drewsum/HEI_Shift_Light/hdw/misc/pcb_scan.jpg

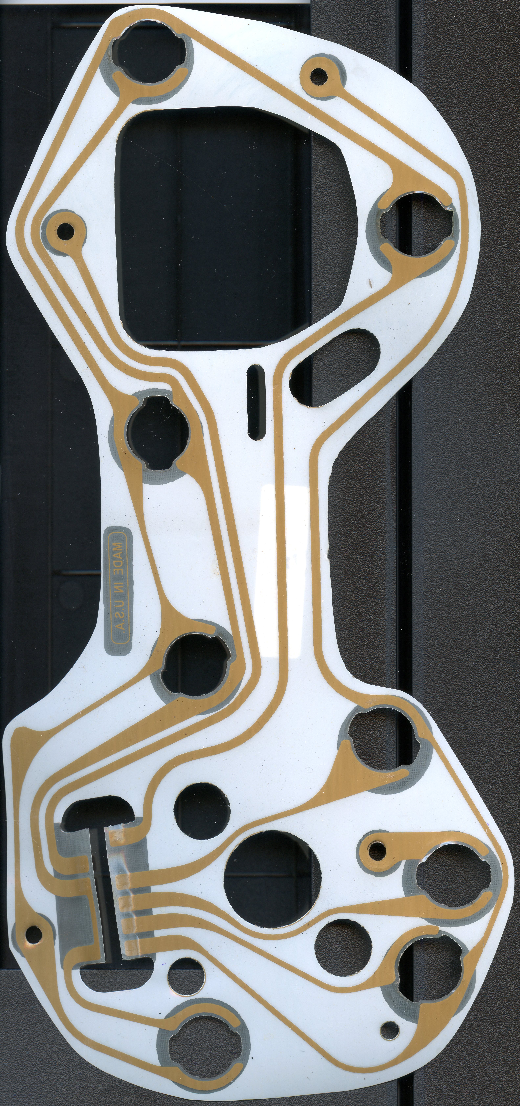
hdw/misc/pcb_scan.jpg
