drewsum/HEI_Shift_Light/README.md

# HEI_Shift_Light
An automotive shift light meant to integrate into the TACH signal from an HEI distributor, to be embedded in a dashboard
