drewsum/HEI_Shift_Light/hdw/misc/indicator_insert.jpg

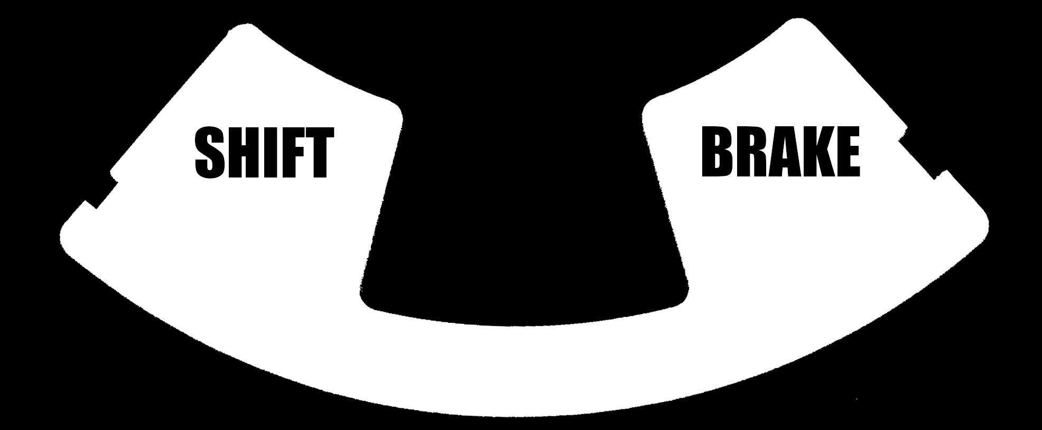
hdw/misc/indicator_insert.jpg
