drewsum/HEI_Shift_Light/hdw/misc/indicator_insert_original.jpg

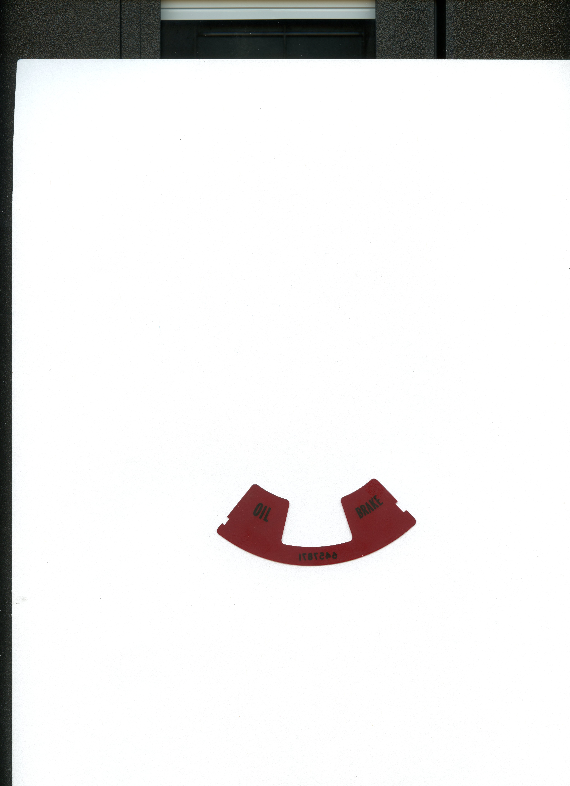
hdw/misc/indicator_insert_original.jpg
