drewsum/HEI_Shift_Light/hdw/misc/ref_photos/PXL_20260610_023209408.jpg

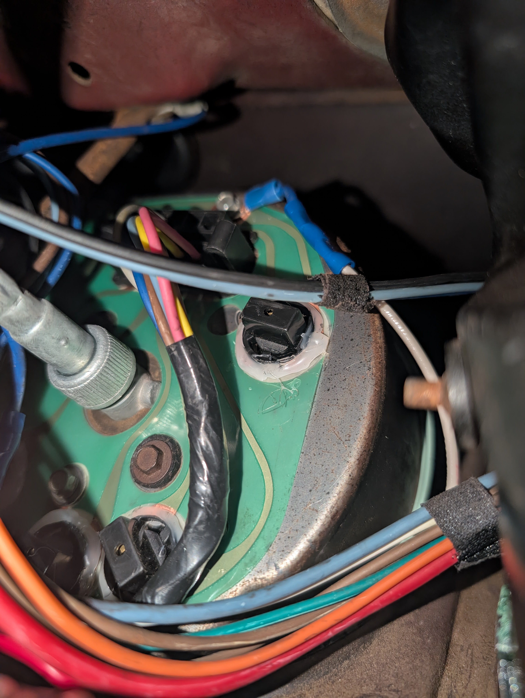
hdw/misc/ref_photos/PXL_20260610_023209408.jpg
