drewsum/HEI_Shift_Light/hdw/HEI_Shift_Light/HEI_Shift_Light.pdf

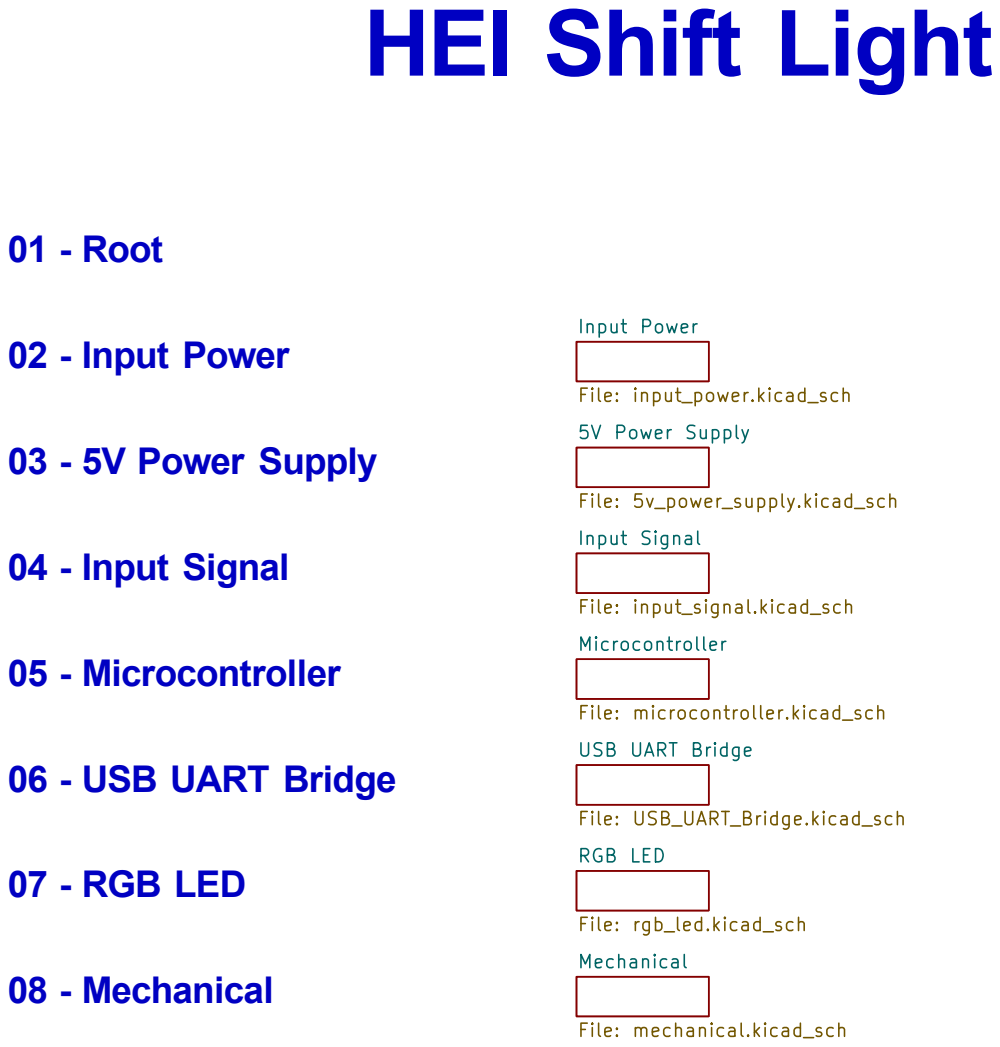
[picture p8: page 1]

Input Power File: input_power.kicad_sch 5V Power Supply File: 5v_power_supply.kicad_sch Mechanical File: mechanical.kicad_sch

Input Signal File: input_signal.kicad_sch Microcontroller File: microcontroller.kicad_sch USB UART Bridge

Drew Maatman
Sheet: /
File: HEI_Shift_Light.kicad_sch
Title: HEI Shift Light

Size: A | Rev: A
KiCad E.D.A. 10.0.3 | Id: 1/8

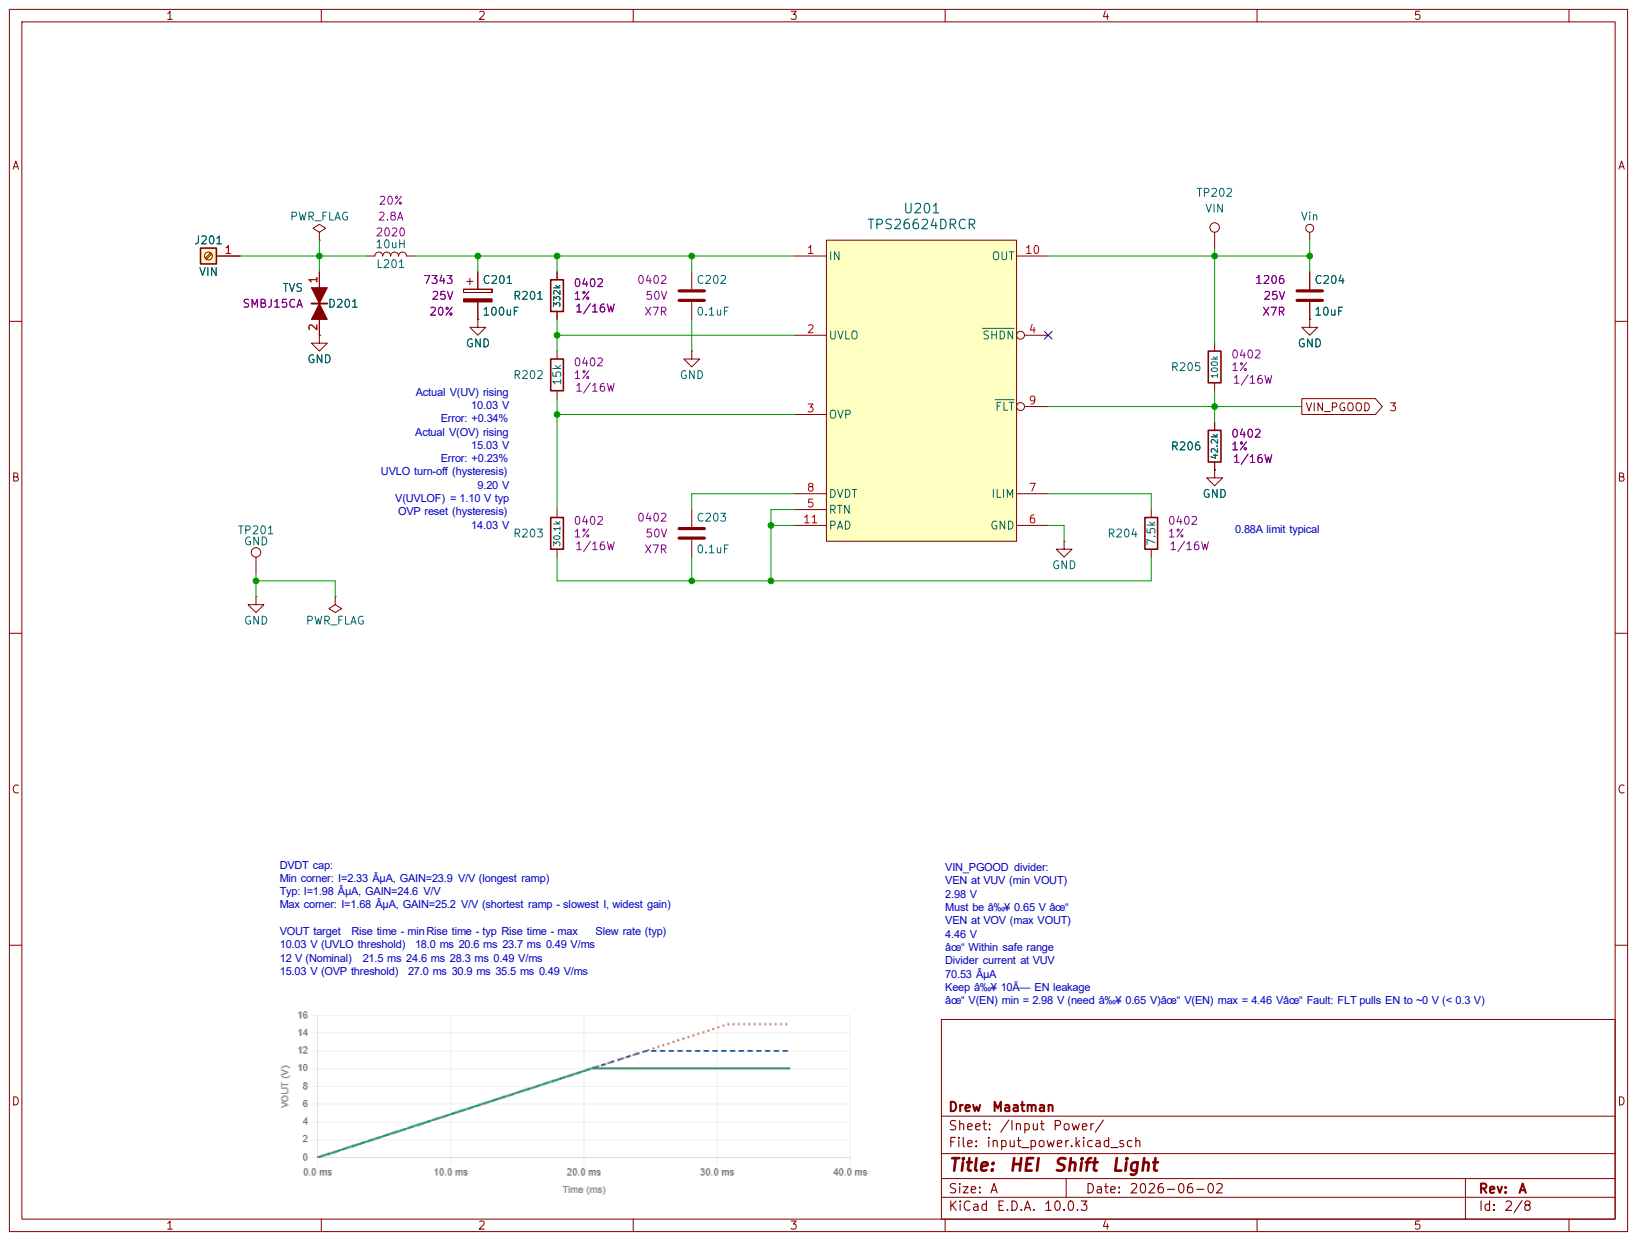
[picture p9: page 2]

0.88A limit typical Actual V(UV) rising

UVLO turn-off (hysteresis) 9.20 V

âœ“ V(EN) min = 2.98 V (need â‰¥ 0.65 V)âœ“ V(EN) max = 4.46 Vâœ“ Fault: FLT pulls EN to ~0 V (< 0.3 V) DVDT cap: Min corner: I=2.33 ÂµA, GAIN=23.9 V/V (longest ramp)

VIN_PGOOD divider: VEN at VUV (min VOUT) 2.98 V Must be â‰¥ 0.65 V âœ“ VEN at VOV (max VOUT) 4.46 V

âœ“ Within safe range Divider current at VUV

Drew Maatman
Sheet: /Input Power/
File: input_power.kicad_sch
Title: HEI Shift Light

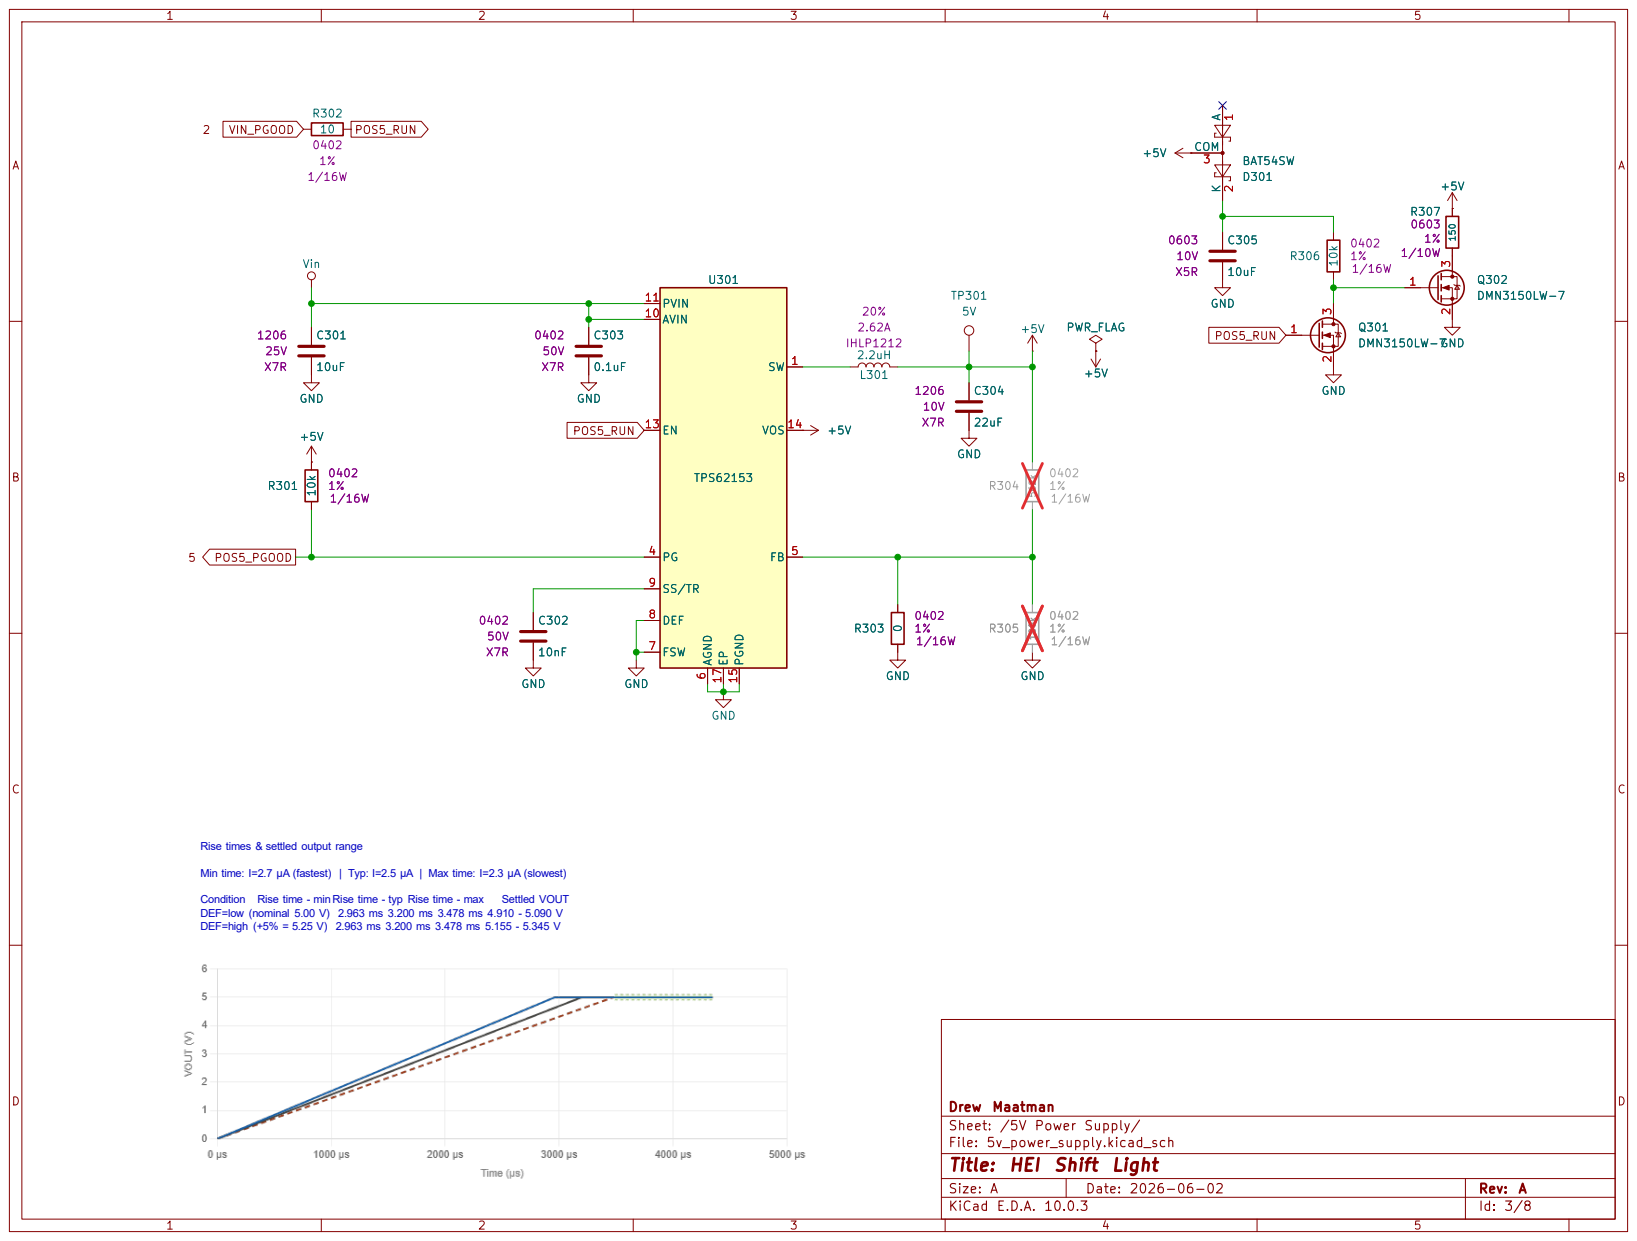
[picture p10: page 3]

Drew Maatman
Sheet: /5V Power Supply/
File: 5v_power_supply.kicad_sch
Title: HEI Shift Light

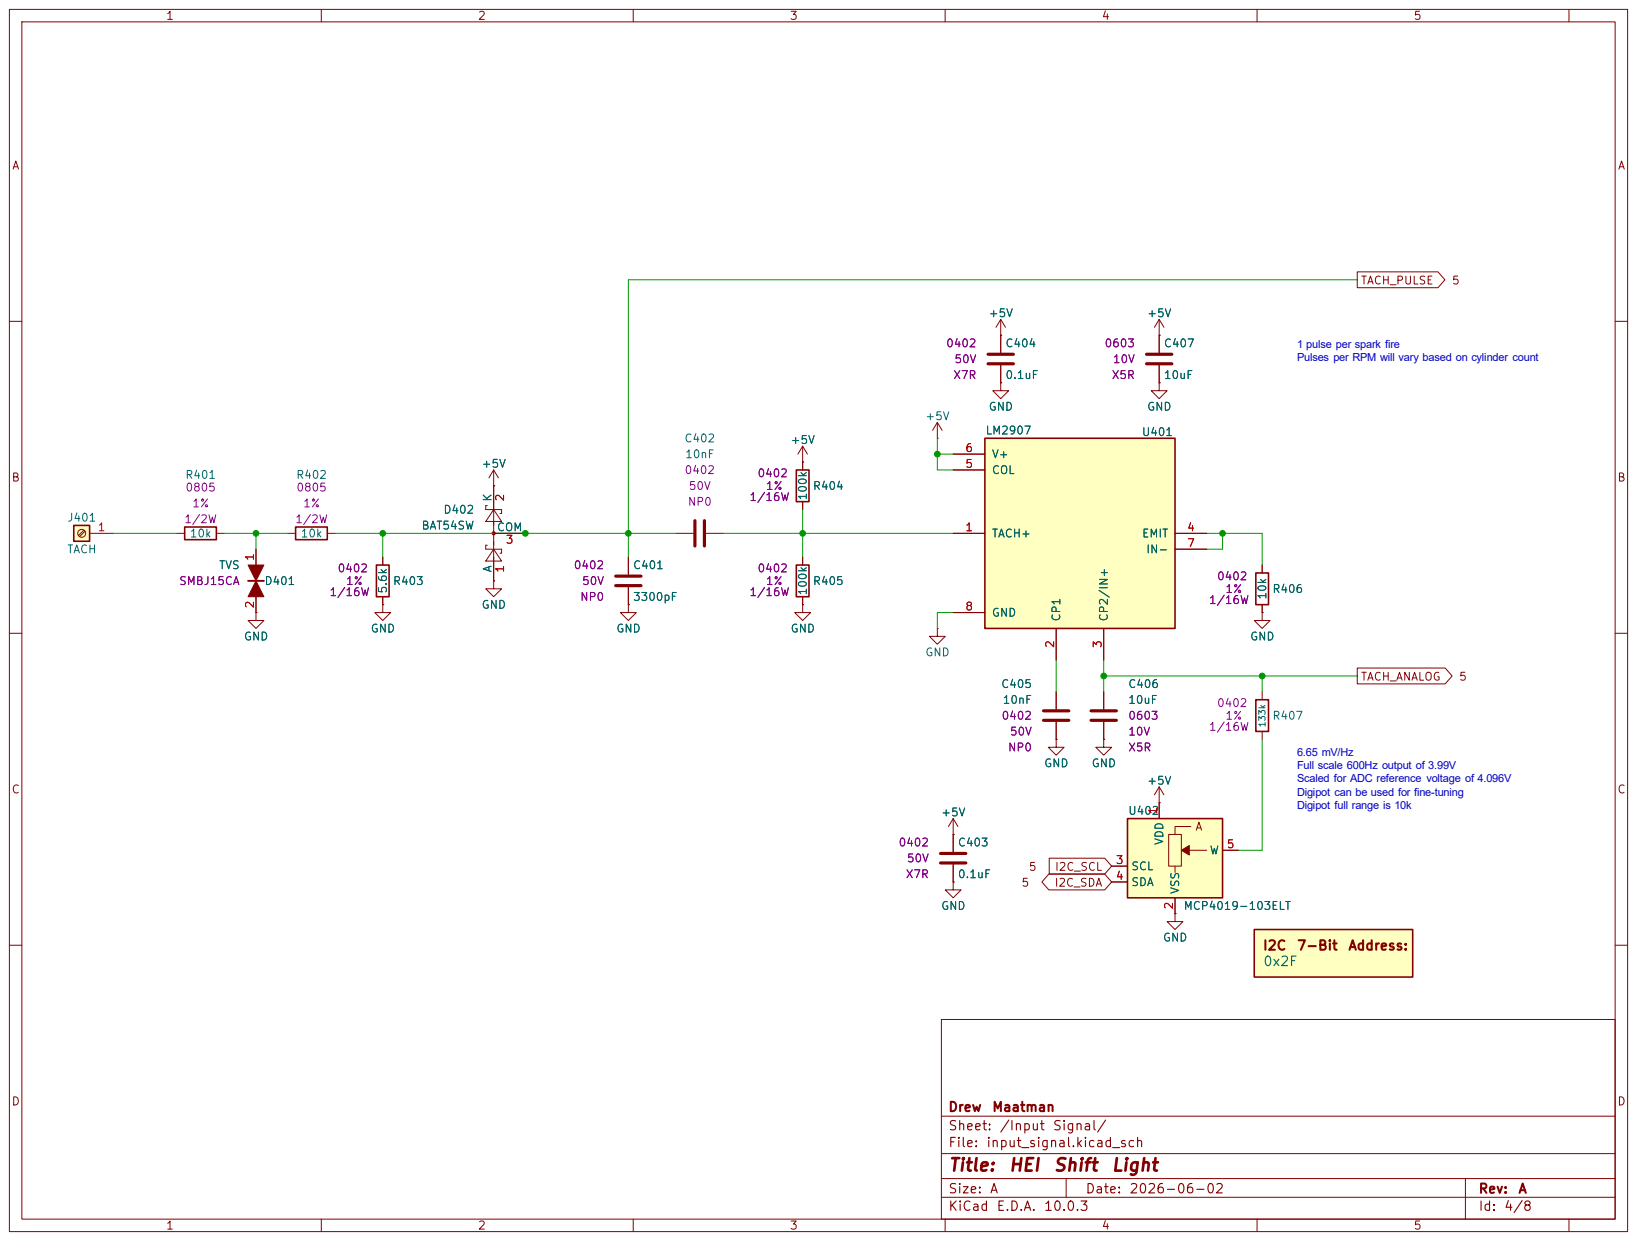
[picture p11: page 4]

1 pulse per spark fire Pulses per RPM will vary based on cylinder count C401

6.65 mV/Hz Full scale 600Hz output of 3.99V

Scaled for ADC reference voltage of 4.096V Digipot can be used for fine-tuning

Digipot full range is 10k

Drew Maatman
Sheet: /Input Signal/
File: input_signal.kicad_sch
Title: HEI Shift Light

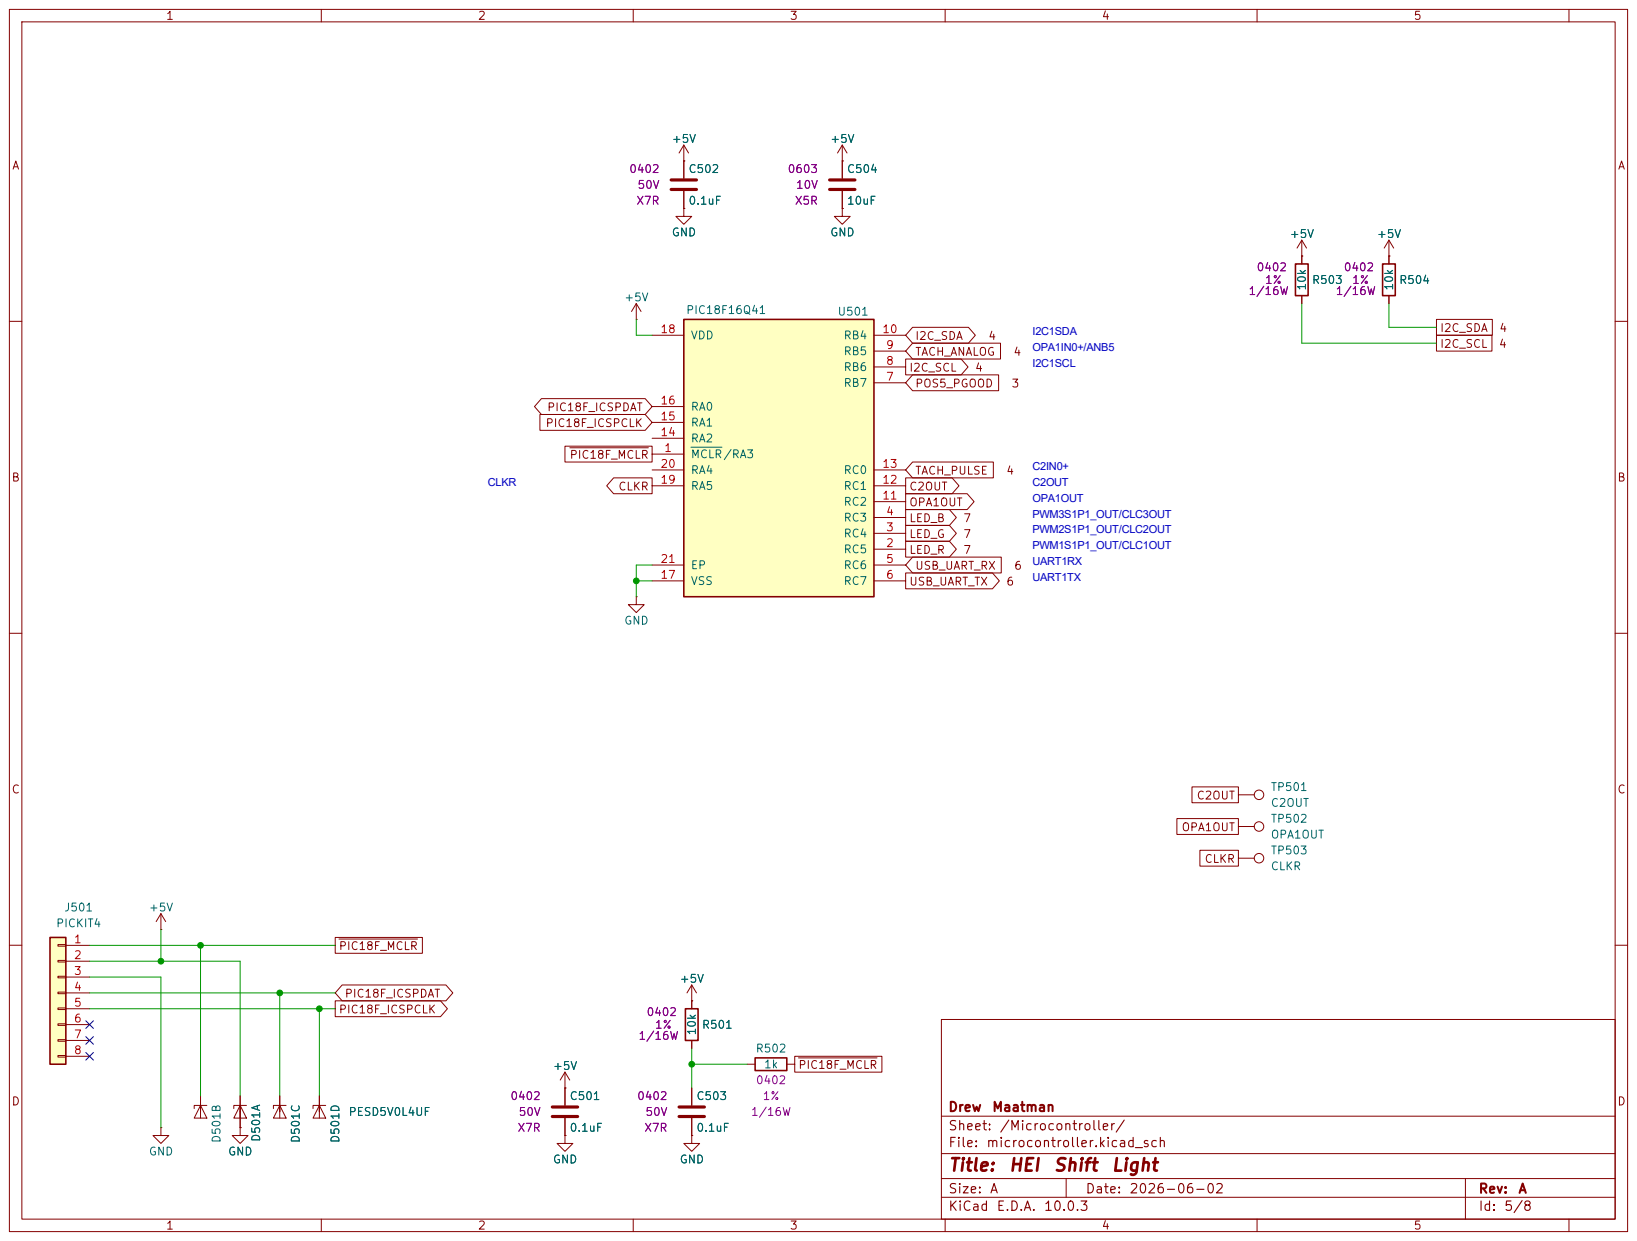
[picture p12: page 5]

Drew Maatman
Sheet: /Microcontroller/
File: microcontroller.kicad_sch
Title: HEI Shift Light

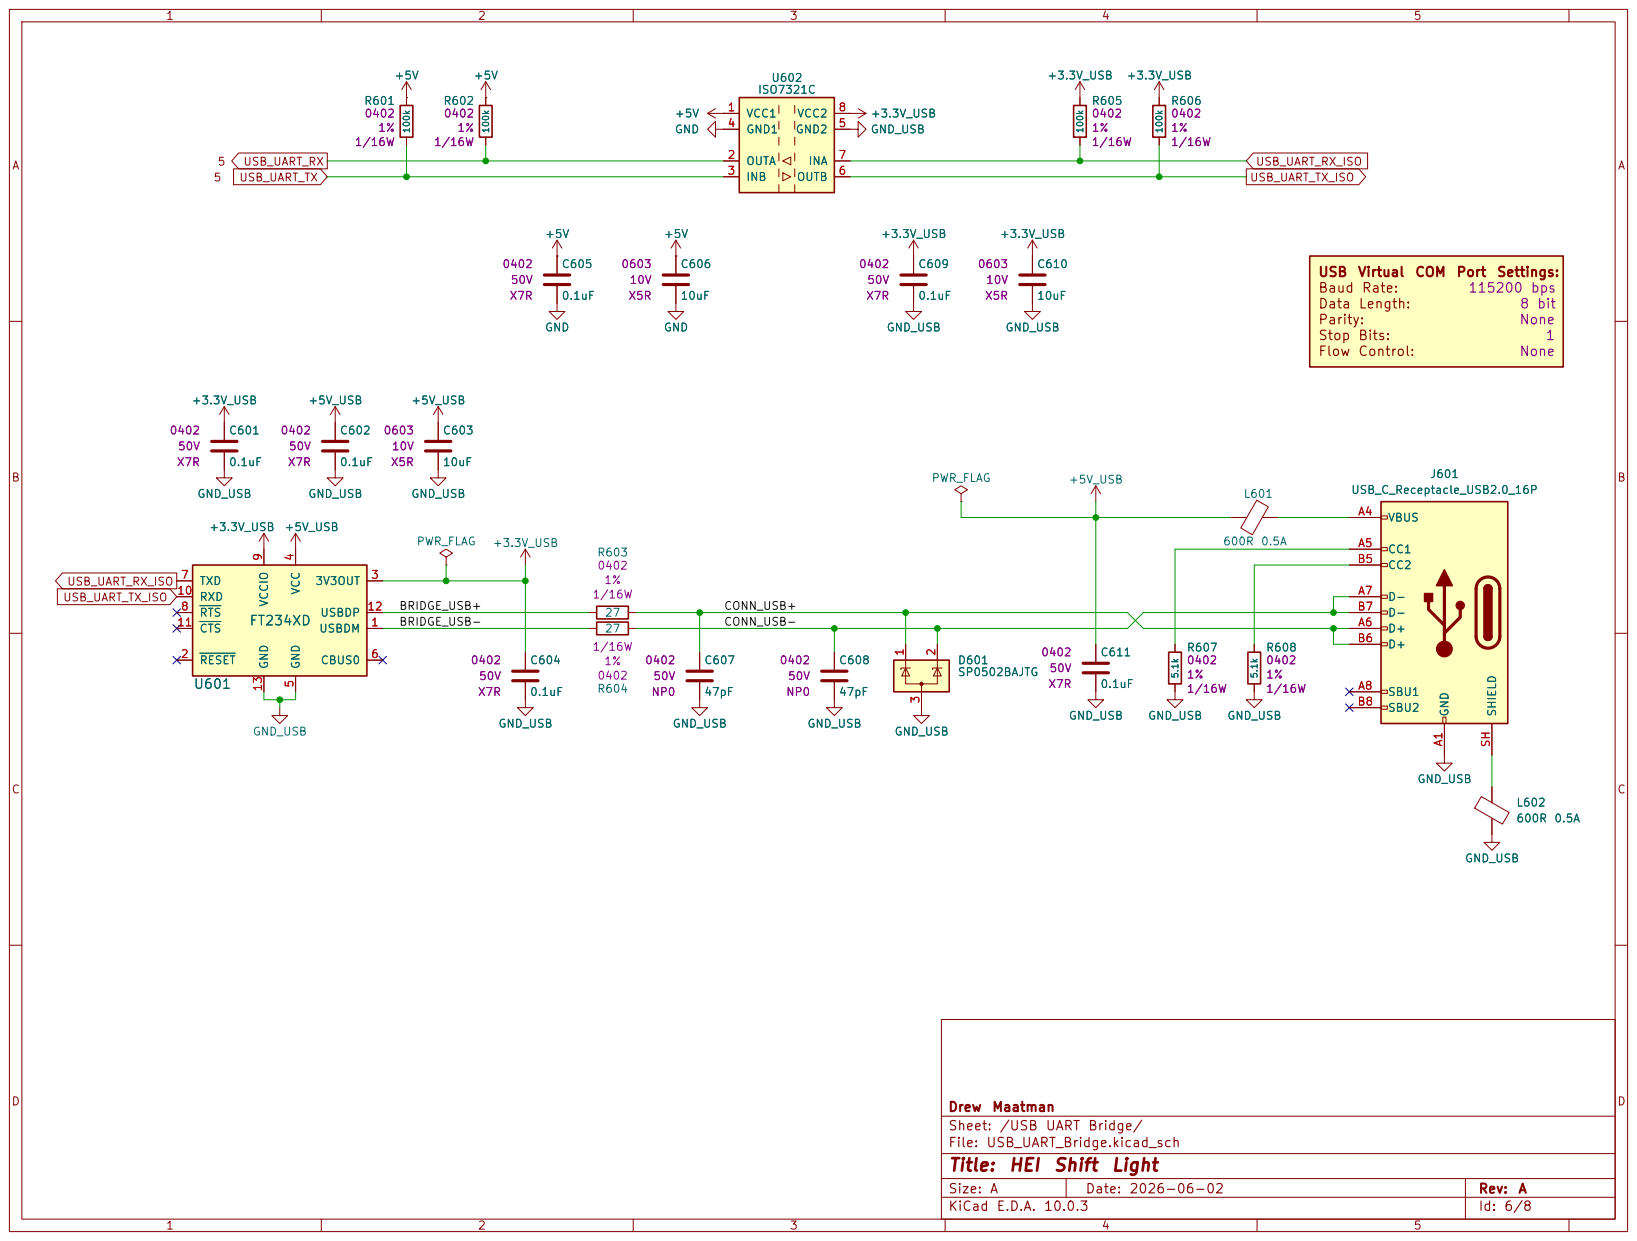
[picture p13: page 6]

USB Virtual COM Port Settings:
Baud Rate:
Data Length:
Parity:
Stop Bits:
Flow Control:

9 RXD 10 CTS 11 USBDP 12 GND

9 RXD 10 CTS 11 USBDP 12 GND 13 C604

Drew Maatman
Sheet: /USB UART Bridge/
File: USB_UART_Bridge.kicad_sch
Title: HEI Shift Light

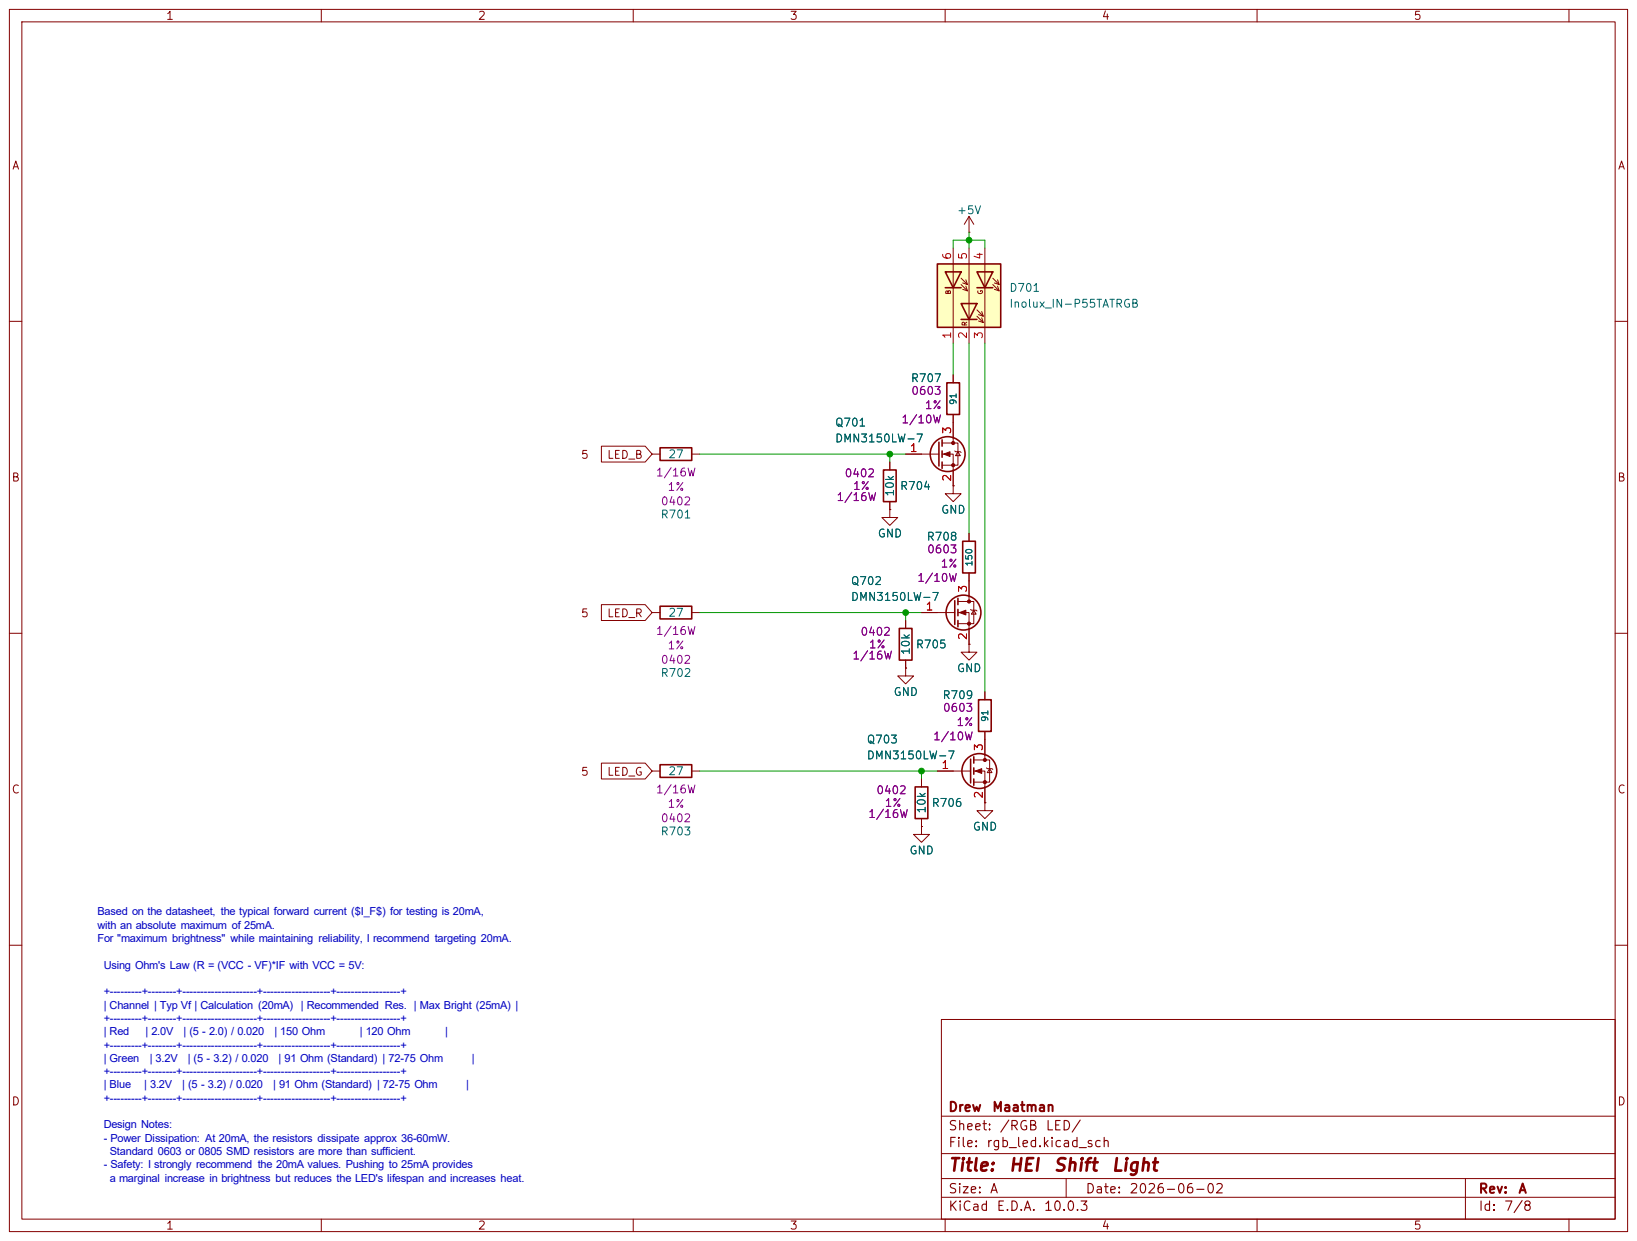
[picture p14: page 7]

Based on the datasheet, the typical forward current ($I_F$) for testing is 20mA, with an absolute maximum of 25mA. For "maximum brightness" while maintaining reliability, I recommend targeting 20mA. Using Ohm's Law (R = (VCC - VF)*IF with VCC = 5V: +---------+--------+---------------------+-------------------+------------------+

Channel | Typ Vf | Calculation (20mA) | Recommended Res. | Max Bright (25mA) | +---------+--------+---------------------+-------------------+------------------+

Drew Maatman
Sheet: /RGB LED/
File: rgb_led.kicad_sch
Title: HEI Shift Light

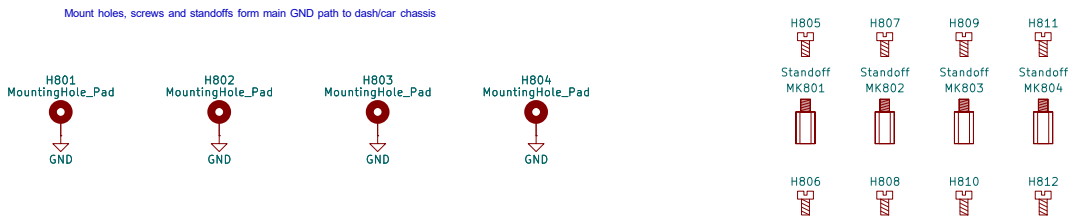
[picture p15: page 8]

Drew Maatman
Sheet: /Mechanical/
File: mechanical.kicad_sch
Title: HEI Shift Light
