drewsum/HEI_Shift_Light/hdw/sim/input_signal/input_signal_draft.asc

C1: cap; 10n
C2: cap; 10n
C3: cap; 1µ
C401: cap; 3300p
D1: schottky; BAT54AHY
D2: schottky; BAT54AHY
D3: TVSdiode; SMBJ24CA
R1: res; 100k
R2: res; 100k
R3: res; 10k
R4: res; 133k
R401: res; 10k
R402: res; 10k
R403: res; 5.6k
U1: LM2907-8
V1: voltage; 5
VTACH: voltage; PWL file=HEI_TACH_V8_1000to6000RPM_10s.txt
Named nets: 0, tach_raw, tach_clamped, vcc, LM2907_IN, tach_tvs, LM2907_OUT
HEI TACH signal at J401
V8 @ 1000 RPM (66.67 Hz, T=15ms)
High: 13.8V (battery / open-collector)
Low:  0.5V  (HEI NPN Vce_sat / dwell)
Flyback: -40V neg spike, +65V ring, damped settle
Alt ripple baked into high state (+/-0.3V shape)
.tran 0 10 0 500n
