drewsum/HEI_Shift_Light/hdw/HEI_Shift_Light/HEI_Shift_Light.kicad_pcb

## KiCad design hdw/HEI_Shift_Light/HEI_Shift_Light.kicad_pcb (2026-07-17)

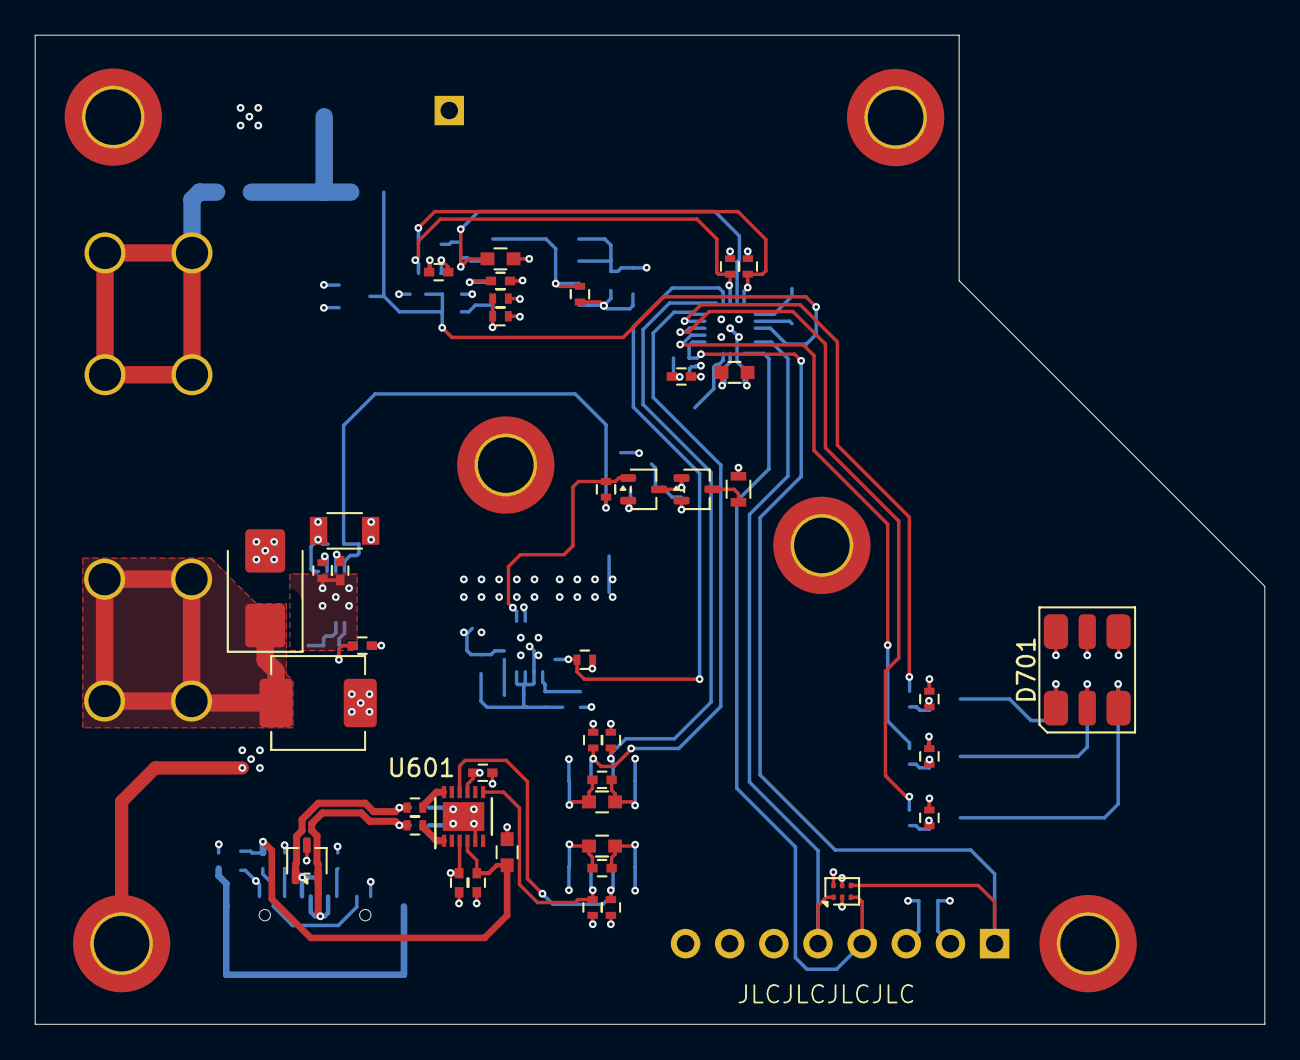
[picture p16: board HEI_Shift_Light.kicad_pcb from above]

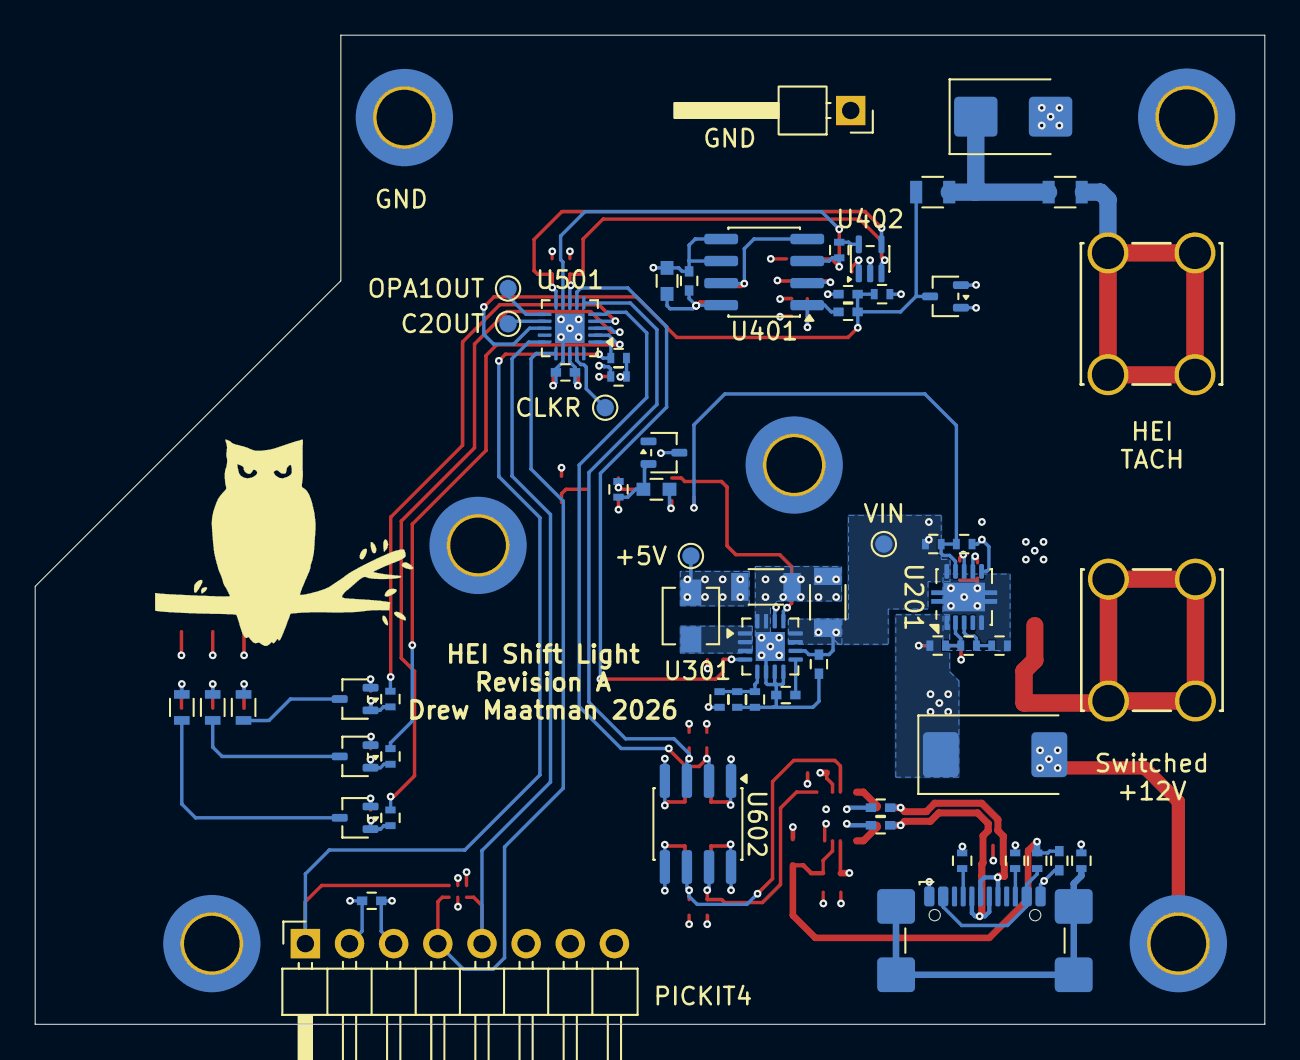
[picture p17: board HEI_Shift_Light.kicad_pcb from below]

Board: 4 copper layers, 70.7 x 56.9 mm, 111 parts (63 on the bottom side), 63 nets.

Parts:
C201: 100uF; CP_EIA-7343-43_Kemet-X
C202, C203, C303, C403, C404, C501, C502, C503, C601, C602, C604, C605, C609, C611: 0.1uF; C_0402
C204, C301: 10uF; C_1206
C302, C402, C405: 10nF; C_0402
C304: 22uF; C_1206
C305, C406, C407, C504, C603, C606, C610: 10uF; C_0603
C401: 3300pF; C_0402
C607, C608: 47pF; C_0402
D201, D401: TVS; D_SMB
D301, D402: BAT54SW; SOT-323_SC-70
D501: PESD5V0L4UF; SOT-886
D601: SP0502BAJTG; SOT-323_SC-70
D701: Inolux_IN-P55TATRGB; LED_Inolux_IN-P55TATRGB_PLCC6_5.0x5.5mm_P1.8mm
H801, H802, H803, H804, H813, H814: MountingHole_Pad; MountingHole_3.2mm_M3_DIN965_Pad_TopBottom
J201: VIN; CONN_7691_KEY
J401: TACH; CONN_7691_KEY
J501: PICKIT4; PICKIT4_Header
J601: USB_C_Receptacle_USB2.0_16P; USB_C_Receptacle_GCT_USB4110
L201: 10uH; L_Vishay_IHLP-2020
L301: 2.2uH; L_Vishay_IHLP-1212
L601, L602: 600R 0.5A; L_0402
Q301, Q302, Q701, Q702, Q703: DMN3150LW-7; SOT-323_SC-70
R201: 332k; R_0402
R202: 15k; R_0402
R203: 30.1k; R_0402
R204: 7.5k; R_0402
R205, R404, R405, R601, R602, R605, R606: 100k; R_0402
R206: 42.2k; R_0402
R301, R306, R406, R501, R503, R504, R704, R705, R706: 10k; R_0402
R302: 10; R_0402
R303: 0; R_0402
R304: 562k; R_0402
R305: 180k; R_0402
R307, R708: 150; R_0603
R401, R402: 10k; R_0805
R403: 5.6k; R_0402
R407: 133k; R_0402
R502: 1k; R_0402
R603, R604, R701, R702, R703: 27; R_0402
R607, R608: 5.1k; R_0402
R707, R709: 91; R_0603
TP201: GND; PinHeader_1x01_P2.54mm_Horizontal
TP202: VIN; TestPoint_Pad_D1.0mm
TP301: 5V; TestPoint_Pad_D1.0mm
TP501: C2OUT; TestPoint_Pad_D1.0mm
TP502: OPA1OUT; TestPoint_Pad_D1.0mm
TP503: CLKR; TestPoint_Pad_D1.0mm
U201: TPS26624DRCR; VSON-10-1EP_3x3mm_P0.5mm_EP1.65x2.4mm
U301: TPS62153; QFN-16-1EP_3x3mm_P0.5mm_EP1.675x1.675mm
U401: LM2907; SOIC-8_3.9x4.9mm_P1.27mm
U402: MCP4019-103ELT; SOT-353_SC-70-5
U501: PIC18F16Q41; VQFN-20-1EP_3x3mm_P0.4mm_EP1.7x1.7mm
U601: FT234XD; DFN-12-1EP_3x3mm_Pitch0.45mm
U602: ISO7321C; SOIC-8_3.9x4.9mm_P1.27mm

Connections:
+3.3V_USB: C601.1, C604.1, C609.1, C610.1, R605.1, R606.1, U601.3 (3V3OUT), U601.9 (VCCIO), U602.8 (VCC2)
+5V: C304.1, C403.1, C404.1, C407.1, C501.1, C502.1, C504.1, C605.1, C606.1, D301.3 (COM), D402.2 (K), D501.6 (K4), D701.4 (AG), D701.5 (AR), D701.6 (AB), J501.2, L301.2, R301.1, R304.1, R307.1, R404.1, R501.1, R503.1, R504.1, R601.1, R602.1, TP301.1 (1_1), U301.14 (VOS), U401.5 (COL), U401.6 (V+), U402.1 (VDD), U501.18 (VDD), U602.1 (VCC1)
+5V_USB: C602.1, C603.1, C611.1, L601.2, U601.4 (VCC)
/Input Power/VIN_BATT: D201.1, J201.1 (Pin_1_1), L201.1
/Input Power/VIN_FILT: C201.1, C202.1, L201.2, R201.1, U201.1 (IN)
/Input Signal/TACH_FILT: D401.1, R401.2, R402.1
/Input Signal/TACH_IN: J401.1 (Pin_1_1), R401.1
/USB UART Bridge/BRIDGE_USB+: R603.2, U601.12 (USBDP)
/USB UART Bridge/BRIDGE_USB-: R604.2, U601.1 (USBDM)
/USB UART Bridge/CONN_USB+: C607.1, D601.1 (K), J601.A6 (D+), J601.B6 (D+), R603.1
/USB UART Bridge/CONN_USB-: C608.1, D601.2 (K), J601.A7 (D-), J601.B7 (D-), R604.1
C2OUT: TP501.1 (1_1), U501.12 (RC1)
CLKR: TP503.1 (1_1), U501.19 (RA5)
GND: C201.2, C202.2, C204.2, C301.2, C302.2, C303.2, C304.2, C305.2, C401.2, C403.2, C404.2, C405.2, C406.2, C407.2, C501.2, C502.2, C503.2, C504.2, C605.2, C606.2, D201.2, D401.2, D402.1 (A), D501.2 (A), D501.5 (A), H801.1 (1_1), H802.1 (1_1), H803.1 (1_1), H804.1 (1_1), H813.1 (1_1), H814.1 (1_1), J501.3, Q301.2 (S), Q302.2 (S), Q701.2 (S), Q702.2 (S), Q703.2 (S), R206.2, R303.2, R305.2, R403.2, R405.2, R406.2, R704.2, R705.2, R706.2, TP201.1 (1_1), U201.6 (GND), U301.6 (AGND), U301.7 (FSW), U301.8 (DEF), U301.15 (PGND), U301.16 (PGND), U301.17 (EP), U401.8 (GND), U402.2 (VSS), U501.17 (VSS), U501.21 (EP), U602.4 (GND1)
GND_USB: C601.2, C602.2, C603.2, C604.2, C607.2, C608.2, C609.2, C610.2, C611.2, D601.3 (A), J601.A1 (GND), J601.A12 (GND), J601.B1 (GND), J601.B12 (GND), L602.2, R607.2, R608.2, U601.5 (GND), U601.13 (GND), U602.5 (GND2)
I2C_SCL: R503.2, U402.3 (SCL), U501.8 (RB6)
I2C_SDA: R504.2, U402.4 (SDA), U501.10 (RB4)
LED_B: R701.2, U501.4 (RC3)
LED_G: R703.2, U501.3 (RC4)
LED_R: R702.2, U501.2 (RC5)
unnamed: C503.1, R501.2, R502.2
unnamed: C305.1, D301.2 (K), R306.1
unnamed: D701.1 (KB), R707.1
unnamed: D701.3 (KG), R709.1
unnamed: D701.2 (KR), R708.1
unnamed: J601.A5 (CC1), R607.1
unnamed: J601.B5 (CC2), R608.1
unnamed: J601.SH (SHIELD), L602.1
unnamed: J601.A4 (VBUS), J601.A9 (VBUS), J601.B4 (VBUS), J601.B9 (VBUS), L601.1
unnamed: L301.1, U301.1 (SW), U301.2 (SW), U301.3 (SW)
unnamed: Q301.3 (D), Q302.1 (G), R306.2
unnamed: Q302.3 (D), R307.2
unnamed: Q701.3 (D), R707.2
unnamed: Q701.1 (G), R701.1, R704.1
unnamed: Q702.3 (D), R708.2
unnamed: Q702.1 (G), R702.1, R705.1
unnamed: Q703.3 (D), R709.2
unnamed: Q703.1 (G), R703.1, R706.1
unnamed: C203.1, U201.8 (DVDT)
unnamed: R204.1, U201.7 (ILIM)
unnamed: R202.2, R203.1, U201.3 (OVP)
unnamed: C203.2, R203.2, R204.2, U201.5 (RTN), U201.11 (PAD)
unnamed: R201.2, R202.1, U201.2 (UVLO)
unnamed: R303.1, R304.2, R305.1, U301.5 (FB)
unnamed: C302.1, U301.9 (SS/TR)
unnamed: C405.1, U401.2 (CP1)
unnamed: R406.1, U401.4 (EMIT), U401.7 (IN-)
unnamed: C402.2, R404.2, R405.1, U401.1 (TACH+)
unnamed: R407.2, U402.5 (W)
OPA1OUT: TP502.1 (1_1), U501.11 (RC2)
PIC18F_ICSPCLK: D501.1 (K1), J501.5, U501.15 (RA1)
PIC18F_ICSPDAT: D501.3 (K2), J501.4, U501.16 (RA0)
POS5_PGOOD: R301.2, U301.4 (PG), U501.7 (RB7)
POS5_RUN: Q301.1 (G), R302.1, U301.13 (EN)
TACH_ANALOG: C406.1, R407.1, U401.3 (CP2/IN+), U501.9 (RB5)
TACH_PULSE: C401.1, C402.1, D402.3 (COM), R402.2, R403.1, U501.13 (RC0)
USB_UART_RX: R602.2, U501.5 (RC6), U602.2 (OUTA)
USB_UART_RX_ISO: R605.2, U601.7 (TXD), U602.7 (INA)
USB_UART_TX: R601.2, U501.6 (RC7), U602.3 (INB)
USB_UART_TX_ISO: R606.2, U601.10 (RXD), U602.6 (OUTB)
VIN_PGOOD: R205.2, R206.1, R302.2, U201.9 (~FLT)
Vin: C204.1, C301.1, C303.1, R205.1, TP202.1 (1_1), U201.10 (OUT), U301.10 (AVIN), U301.11 (PVIN), U301.12 (PVIN)
~PIC18F_MCLR: D501.4 (K3), J501.1, R502.1, U501.1 (~MCLR/RA3)
