drewsum/HEI_Shift_Light/(commit log)

2026-05-23 started hardware project
    [3v3_power_suply.kicad_sch, HEI_Shift_Light.kicad_pcb, HEI_Shift_Light.kicad_sch, input_power.kicad_sch, input_signal.kicad_sch, microcontroller.kicad_sch]
2026-05-23 Added input power filtering
    [3v3_power_suply.kicad_sch, input_power.kicad_sch]
2026-05-24 more schematic progress
    [HEI_Shift_Light.kicad_sch, USB_UART_Bridge.kicad_sch, input_power.kicad_sch, input_signal.kicad_sch, microcontroller.kicad_sch, usb_port.kicad_sch]
2026-05-30 populated input protection circuit passive components, updated PIC pinout, added stuff to frequency to voltage converter circuit
    [5v_power_supply.kicad_sch, HEI_Shift_Light.kicad_sch, USB_UART_Bridge.kicad_sch, input_power.kicad_sch, input_signal.kicad_sch, microcontroller.kicad_sch, rgb_led.kicad_sch]
2026-05-30 added more shit, RGD LED, LC input filter
    [5v_power_supply.kicad_sch, HEI_Shift_Light.kicad_sch, USB_UART_Bridge.kicad_sch, input_power.kicad_sch, input_signal.kicad_sch, microcontroller.kicad_sch, rgb_led.kicad_sch]
2026-06-01 filled in digikey part numbers
    [5v_power_supply.kicad_sch, HEI_Shift_Light.kicad_pcb, HEI_Shift_Light.kicad_sch, USB_UART_Bridge.kicad_sch, input_power.kicad_sch, input_signal.kicad_sch, microcontroller.kicad_sch, rgb_led.kicad_sch]
2026-06-01 fixed a few digikey pns
    [USB_UART_Bridge.kicad_sch, input_signal.kicad_sch]
2026-06-02 Added input signal path simulation
    [5v_power_supply.kicad_sch, USB_UART_Bridge.kicad_sch, input_power.kicad_sch, input_signal.kicad_sch, microcontroller.kicad_sch, rgb_led.kicad_sch]
2026-06-02 change LM2907 filter cap to 10uF
    [input_signal.kicad_sch]
2026-06-02 fixed some digikey pns
    [5v_power_supply.kicad_sch, USB_UART_Bridge.kicad_sch, input_power.kicad_sch, input_signal.kicad_sch, microcontroller.kicad_sch]
2026-06-03 moved GND connections to mount holes, updated gitignore
    [HEI_Shift_Light.kicad_sch, input_power.kicad_sch, mechanical.kicad_sch]
2026-06-03 added component datasheet properties
    [5v_power_supply.kicad_sch, USB_UART_Bridge.kicad_sch, input_power.kicad_sch, input_signal.kicad_sch, mechanical.kicad_sch, microcontroller.kicad_sch, rgb_led.kicad_sch]
2026-06-03 updated a lot of font, table of contents
    [5v_power_supply.kicad_sch, HEI_Shift_Light.kicad_sch, USB_UART_Bridge.kicad_sch, input_power.kicad_sch, input_signal.kicad_sch, mechanical.kicad_sch, microcontroller.kicad_sch, rgb_led.kicad_sch]
2026-06-07 cleaned up digikey pns
    [5v_power_supply.kicad_sch, HEI_Shift_Light.kicad_sch, USB_UART_Bridge.kicad_sch, hei_shift_light.kicad_pcb, hei_shift_light.kicad_sch, input_power.kicad_sch, input_signal.kicad_sch, microcontroller.kicad_sch]
2026-06-08 fixed some footprints, pulled into PCB
    [5v_power_supply.kicad_sch, HEI_Shift_Light.kicad_pcb, USB_UART_Bridge.kicad_sch, input_power.kicad_sch, input_signal.kicad_sch, mechanical.kicad_sch, microcontroller.kicad_sch]
2026-06-08 Added dashboard PCB reference data
    [HEI_Shift_Light.kicad_pcb]
2026-06-08 arranged components in PCB
    [HEI_Shift_Light.kicad_pcb, USB_UART_Bridge.kicad_sch]
2026-06-09 added stackup, design rules
    [HEI_Shift_Light.kicad_pcb, input_power.kicad_sch, input_signal.kicad_sch]
2026-06-09 fix some netclass issues
    [HEI_Shift_Light.kicad_pcb]
2026-06-09 started rough routing
    [HEI_Shift_Light.kicad_pcb]
2026-06-10 added reference photos
    [HEI_Shift_Light.kicad_pcb]
2026-06-10 came up with rough component placement
    [HEI_Shift_Light.kicad_pcb, mechanical.kicad_sch]
2026-06-13 Added indicator insert
2026-06-20 Verified board outline against dash mechanical constraints
    [HEI_Shift_Light.kicad_pcb, mechanical.kicad_sch]
2026-06-23 routed most of board
    [HEI_Shift_Light.kicad_pcb, microcontroller.kicad_sch]
2026-06-23 finished routing
    [HEI_Shift_Light.kicad_pcb]
2026-06-23 added silkscreen project description, DRC checks
    [HEI_Shift_Light.kicad_pcb]
2026-07-03 generated gerbers, BOM
    [HEI_Shift_Light-B_Cu.gbr, HEI_Shift_Light-B_Mask.gbr, HEI_Shift_Light-B_Silkscreen.gbr, HEI_Shift_Light-Edge_Cuts.gbr, HEI_Shift_Light-F_Cu.gbr, HEI_Shift_Light-F_Mask.gbr, HEI_Shift_Light-F_Silkscreen.gbr, HEI_Shift_Light-In1_Cu.gbr]
